JEB12345/Sensor_Board/(commit log)

2013-07-02 Added the empty KiCAD project for the Sensor_Board
2013-07-02 Recommiting for practice and to initialize the real Sensor_Board Files
2013-07-07 Comming a new file structure for organization
    [Sensor_Board.sch]
2013-07-07 Removing Sensor_Board.pro
2013-07-07 Added more to the schematics, basic PIC setup and CAN Transiever
    [Sensor_Board.sch]
2013-07-08 Added ADC and TI CAN Trans.
    [Sensor_Board.sch]
2013-07-08 Adding schematic with changes from yesterday
    [Sensor_Board.sch]
2013-07-08 Deleted the kicadlibrary git repo folder
2013-07-08 removing Sensor_Board.pro from local repo
2013-07-08 Changed the ADC from AD7192 to AD7193
2013-07-09 Adding the changes from today, mainly changing some parts and basic wiring.... didn't get as much done as I would have liked
    [Sensor_Board.sch]
2013-07-09 Revert "Adding the changes from today, mainly changing some parts and basic wiring.... didn't get as much done as I would have liked"
    This reverts commit 15443ba5e97c99da6254b6d753ebc1158bf0ebd2.
    [Sensor_Board.sch]
2013-07-09 Added a connector for the CAN network and some general purpose LEDs
    [Sensor_Board.sch]
2013-07-11 Added Data sheets fro the FDFMA3N109 and AP7363 chips. Plus rolling updates to schematic.
    [Sensor_Board.sch]
2013-07-12 Added a power switcher and an IMU, still need a compass
    [Sensor_Board.sch]
2013-07-12 Switched the IMU from MPU-6000 to MPU-9150 w/ integrated compass
    [Sensor_Board.sch]
2013-07-13 Added the MPU-9150 and an RGB LED to the board. Also added current limiting resistors to the status LEDs
    [Sensor_Board.sch]
2013-07-15 Went back to the MPU-6000 IMU based on the 9150 having a lot of issues. Also added an RGB LED for status.
    [Sensor_Board.sch]
2013-07-16 started placing the pinheaders for an XBee wifi module. Also placing two nMOSFET for LED switching.
    [Sensor_Board.sch]
2013-07-16 Have to go to a meeting....
    [Sensor_Board.sch]
2013-07-16 Finished the lab meeting
    [Sensor_Board.sch]
2013-07-17 Final schematic design as of 16/7/13
    [Sensor_Board.sch]
2013-07-17 Fixed some wiring issues fromt he previously commited final version
    [Sensor_Board.sch]
2013-07-17 Started a BOM and netlist for components. Also adding information like package and pricing. Still needs to be updated.
    [Sensor_Board.csv, Sensor_Board.sch]
2013-07-17 Made some teaks. Still need ADC filtering and resistors
    [Sensor_Board.sch]
2013-07-18 Added a precision resistor bank for the Half-Bridge
2013-07-19 Added information on each component for the BOM. Still need to add info on some of the caps, pin-headers, and switch.
    [Sensor_Board.csv, Sensor_Board.sch]
2013-07-19 Added the Analog schematic, which I put onto a linked sheet in KiCAD.
    [Analog.sch]
2013-07-19 Put some more information for purchasing.
    [Analog.sch, Sensor_Board.csv, Sensor_Board.sch]
2013-07-20 Changed the Voltage in so that the board will take voltage from the Motor board or supply voltage when the 24V is pulled
    [Analog.sch, Sensor_Board.sch, Vin_and_BackUp.sch]
2013-07-22 Made a BOM and tried to complete it as much as possible. Had to use the xml->csv method described in KiCAD's documentation.
    [Analog.sch, Sensor_Board.csv, Sensor_Board.sch, Vin_and_BackUp.sch]
2013-07-22 Associated all components with either foot prints for layout. Also added library and module files for various components.
    [Analog.sch, Sensor_Board.sch, Vin_and_BackUp.sch]
2013-07-22 Added the conversion script for eagle to kicad library files. Only works for Eagle version <=5
2013-07-24 Added the board layout file. Made some corrections to the schematic as well.
    [Analog.sch, Sensor_Board.kicad_pcb, Vin_and_BackUp.sch]
2013-07-25 Moved the .kicad_pcb file to the board folder. Also did some more routing.
    [Analog.sch, Sensor_Board.kicad_pcb, Sensor_Board.sch, Vin_and_BackUp.sch]
2013-07-26 Changed the size of the board. Routed the CAN connectors and CAN transiver. Also finished some of the ADC routing.
    [Sensor_Board.kicad_pcb]
2013-07-26 This commit is to fix the bad push from a bad merger.
    [Sensor_Board.kicad_pcb, Vin_and_BackUp.sch]
2013-07-26 More routing stuffs complete.
    [Sensor_Board.kicad_pcb, Sensor_Board.sch, Vin_and_BackUp.sch]
2013-07-31 Finally finished layout the board. Added the XBEE Wifi datasheet as well.
    [Analog.sch, Sensor_Board.kicad_pcb, Sensor_Board.sch, Vin_and_BackUp.sch]
2013-07-31 Cleaned up the Silkscreen.
    [Sensor_Board.kicad_pcb]
2013-08-01 Fixed the XBee pinheader issue. Added information onto the Silkscreen
    Still Need To:
    -Label Connectors
    -Move Power connectors
    [Analog.sch, Sensor_Board.kicad_pcb, Sensor_Board.sch, Vin_and_BackUp.sch]
2013-08-02 Found out that there are two different remappable pins of the dsPIC33E. Some are input/out remappable and some are input only remappable. Fixed the XBee SPI, XBEE nRESET, and Green LED on the RGB LED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
    [Analog.sch, Sensor_Board.kicad_pcb, Sensor_Board.sch, Vin_and_BackUp.sch]
2013-08-02 Added a zip of all the gerber files
2013-08-05 Fixed the ground plans so that AGND and GND are connected. Added the Gerber files. Sent out for first fabrication run today.
    [Sensor_Board.kicad_pcb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]
2013-08-07 Added some 3D files for the 3D viewer.
    [Sensor_Board.kicad_pcb]
2013-08-07 Changed the XBee pins to be 2mm spacing. Not the 0.1" pin spacing.
    [Sensor_Board.kicad_pcb]
2013-08-07 Changed the Silkscreen for XBee to match the pin placement.
    [Sensor_Board.kicad_pcb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]
2013-09-18 Fixed the issue of pins 19 and 20 being flipped.
    [Sensor_Board.kicad_pcb, Sensor_Board.sch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]
2013-09-25 Changed the Mounting holes to accept M3 screws
    [Analog.sch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]
2013-10-24 Updated to version 1.2
    [Analog.sch, Sensor_Board.kicad_pcb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]
2013-10-29 Added notes to be completed on next revision
    [Sensor_Board.sch]
2013-12-31 Started making changes to the Sensor Board for v.2
    [Analog.sch, Sensor_Board.kicad_pcb, Sensor_Board.sch, Vin_and_BackUp.sch]
2014-01-01 Continuing changes for v2
    [Analog.sch, Sensor_Board.sch, Vin_and_BackUp.sch]
2014-01-08 Almost finished with V2.0 of the sensor board. Need to add one more trace... hopefully.
    [Analog.sch, BBB_Pins.sch, Sensor_Board.kicad_pcb, Sensor_Board.sch, Vin_and_BackUp.sch]
2014-01-09 Finished laying out the sensor board v2.0. Still need to look over to double check everything.
    [BBB_Pins.xlsx, Sensor_Board.kicad_pcb, Sensor_Board.sch]
2014-01-09 Cleaned up some of the Text and SilkScreen on the board.
    [Sensor_Board.kicad_pcb]
2014-01-09 Clean up.
    [Sensor_Board.kicad_pcb]
2014-01-10 Made changes to Ground Planes for better pours.
    [Analog.sch, BBB_Pins.sch, Sensor_Board.kicad_pcb, Sensor_Board.sch, Vin_and_BackUp.sch]
2014-01-10 Changed the Silk Screen and added bottom mask for BBB pins.
    [Sensor_Board.kicad_pcb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]
2014-01-31 Generated a CSV BOM located in the top directory as well as pushing some of the final changes.
    [Analog.sch, BBB_Pins.sch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]
2014-06-18 Changed the 3.3V->3V LDO from AS1359 to AS1953 Still need to work on refactoring schematic for new version of KiCAD
    [Analog.sch, BBB_Pins.sch, Sensor_Board.kicad_pcb, Sensor_Board.sch, Vin_and_BackUp.sch]
2014-06-18 More small changes relating to new LDO
    [Analog.sch, BBB_Pins.sch, Sensor_Board.kicad_pcb, Vin_and_BackUp.sch]
2014-06-26 Changed the Microclasp connectors on board to match all other boards
    [Analog.sch, BBB_Pins.sch, Sensor_Board.kicad_pcb, Sensor_Board.sch, Vin_and_BackUp.sch]
2014-08-14 Added the Datasheet for the new AMS 3.3V->3V LDO
2015-09-07 Minor Changes to original Sensor Board design
    [Analog.sch, BBB_Pins.sch, Sensor_Board.kicad_pcb, Sensor_Board.sch, Vin_and_BackUp.sch]
